alexanderfriman/mars-rover/README.md

# Tellus Stick-To-It-Iveness Rover
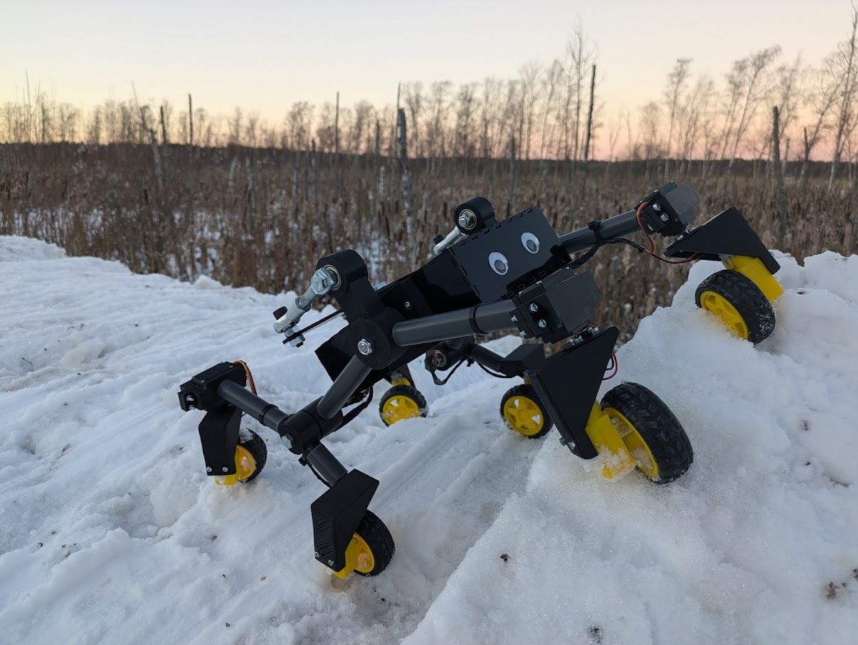
[picture p1: images/tellus_rover.jpg]

Created by: Alexander Friman, Simon Nordgren, Martin Björkell & Jonas Båsk.

## Video
<a href="http://www.youtube.com/watch?feature=player_embedded&v=wtrcZi1KN1w
" target="_blank">IMAGE ALT TEXT HERE</a>

## Introduction
This is a robotics project done at Aalto University for the Sähköpaja course. We built a miniature rover inspired by NASA's mars rover Perseverance. The rover features the rocker-bogie suspensionsystem and Ackermann's steering geometry, but does not include any measuring devices. It is controlled through bluetooth with a PlayStation 4 controller which is connected to an ESP32. 

## Parts
| Amt | Electrical components | 
| --- | --- |
|  1x | ESP32 Wrover E | 
|  2x | TB6612FNG motordriver |
|  6x | DG01D DC-motor |
|  4x | DM996 Servomotors (180 degrees) |
|  2x | 9V powersupply |
|  1x | DC-to-DC step down converter |
|  1x | Breadboard |
|  1x | LD33CV (3.3V) Voltage regulator |
|  1x | Capasitor 100u |
|  1x | PS4 Controller |
| | Wires |

| Amt | Mechanical components |
| --- | --- |
|  2x | Rod-end ball joint (M8) |
|  2x | Eye hinge bolt (M8) |
| 14x | Ball bearings 8x22x7mm |
|  6x | Wheel |
| | PVC pipe 20mm (about 80cm) |
| | Acrylic sheet 3mm |
| | Bolts, nuts, washers, skrews |

## Circuit Diagram
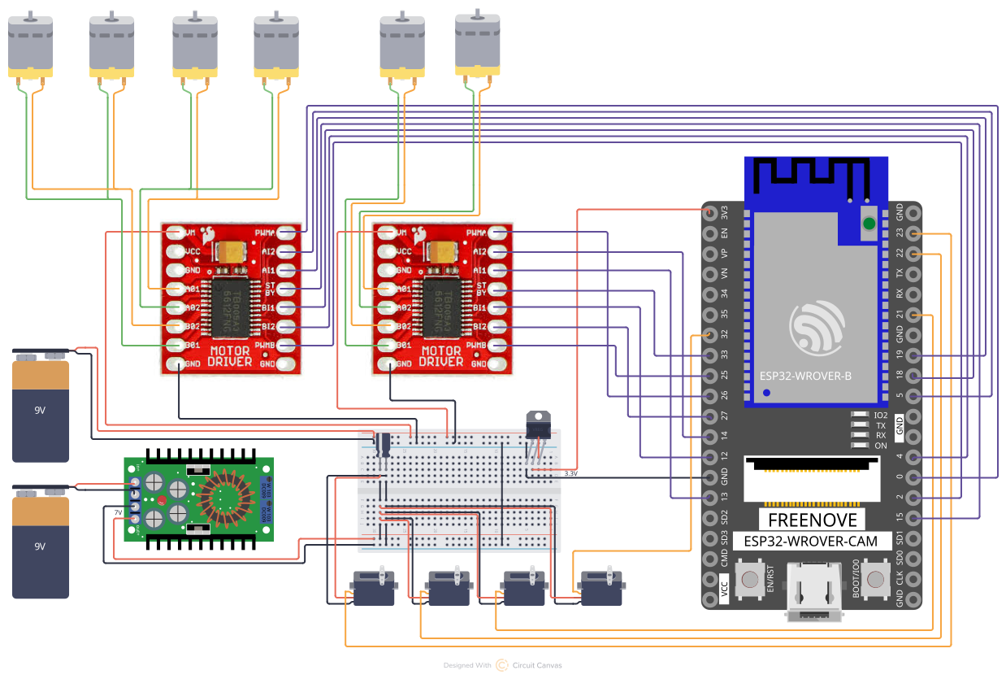
[picture p2: images/Curcuit_Diagram.png]


## 3D-Printed Parts
2x back_servo.stl<br/>
3x box_connector.stl<br/>
2x front_servo.stl<br/>
2x leg_inside.stl<br/>
2x leg_main.stl<br/>
2x leg_outside.stl<br/>
1x middle_wheelpart.stl<br/>
4x outer_wheelpart.stl<br/>
4x servo_backside.stl<br/>

## Acrylic parts
[Acrylic Parts](https://github.com/alexanderfriman/mars-rover/blob/main/Mars_Rover_Box.svg)

## Ackermann steering geometry
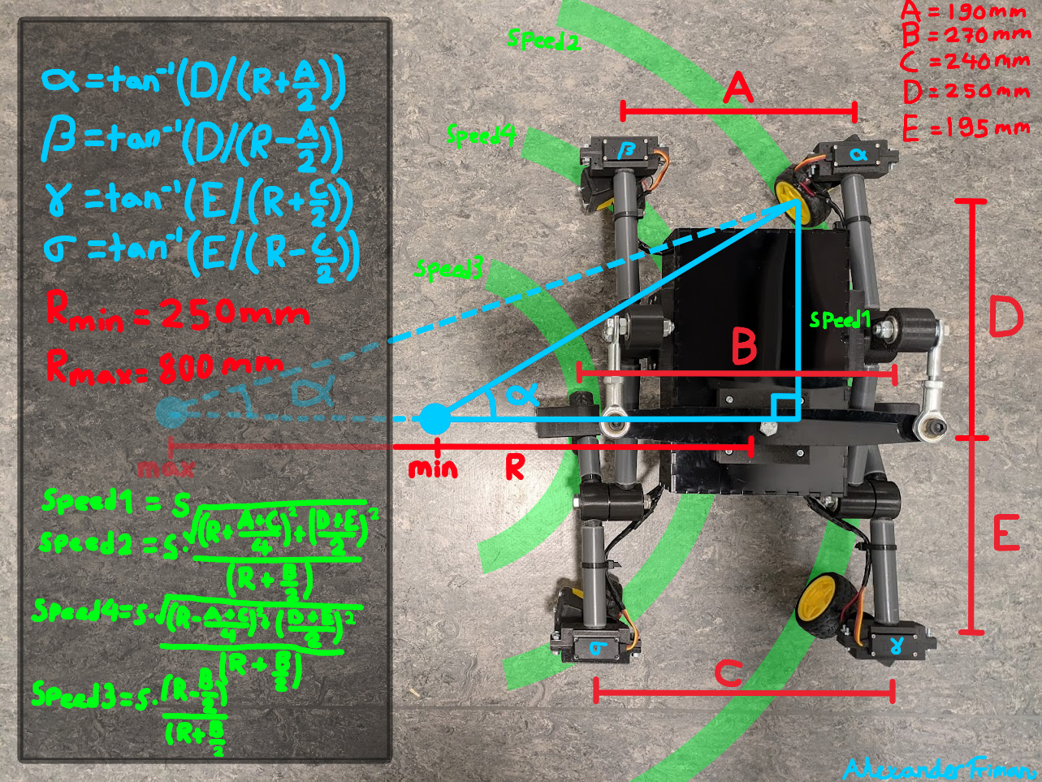
[picture p3: images/Ackermann_steering.png]
