alexanderfriman/mars-rover/3D-parts/leg_main.stl

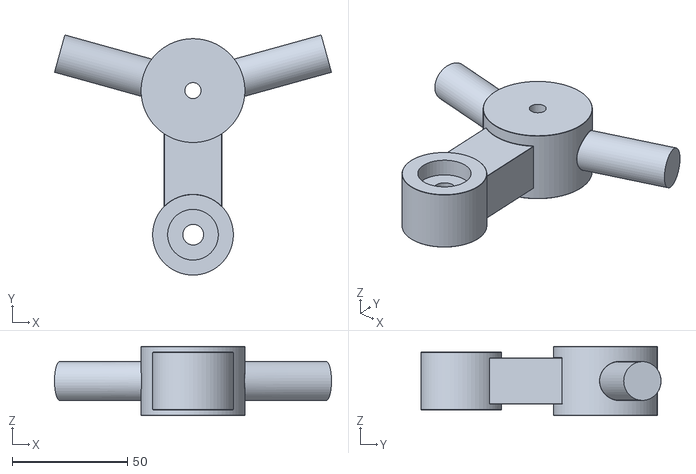
[picture p4: CAD file, 2025-02-15]
3D-parts/leg_main.stl
120.1 x 104.1 x 30.0
