alexanderfriman/mars-rover/3D-parts/servo_backside.stl

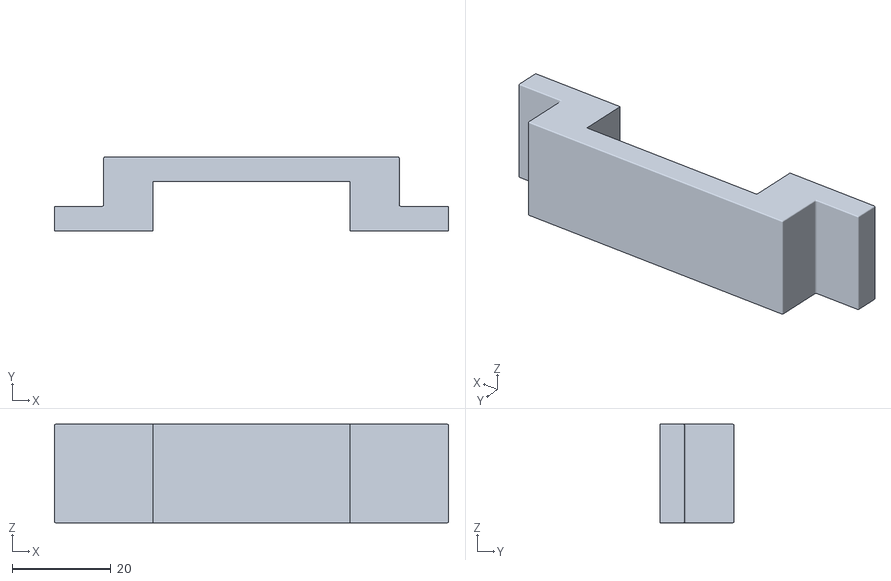
[picture p5: CAD file, 2025-02-15]
3D-parts/servo_backside.stl
80.0 x 15.0 x 20.0
