alexanderfriman/mars-rover/3D-parts/back_servo.stl

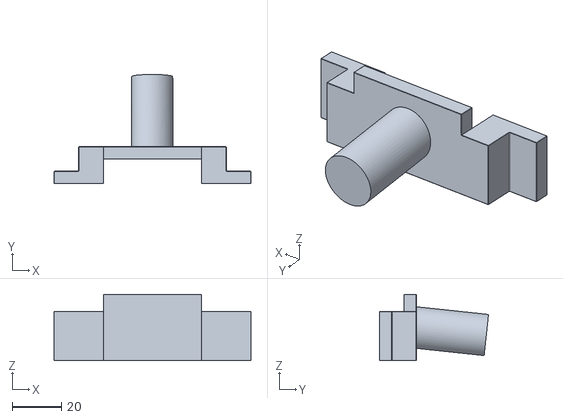
[picture p6: CAD file, 2025-02-15]
3D-parts/back_servo.stl
80.0 x 44.3 x 27.0
