alexanderfriman/mars-rover/3D-parts/outer_wheelpart.stl

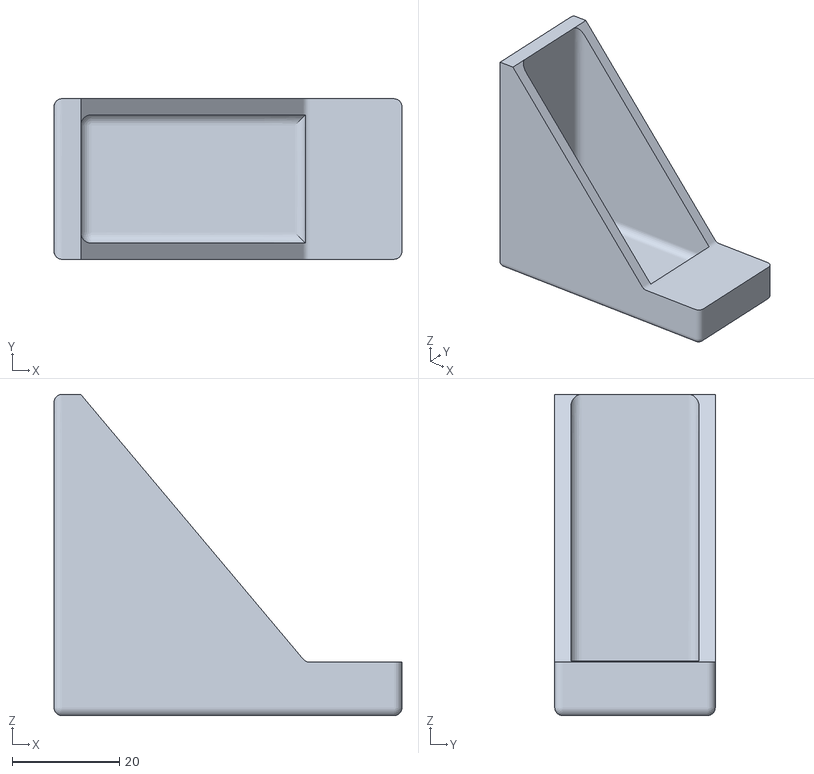
[picture p7: CAD file, 2025-02-15]
3D-parts/outer_wheelpart.stl
65.0 x 30.0 x 60.0
