alexanderfriman/mars-rover/3D-parts/front_servo.stl

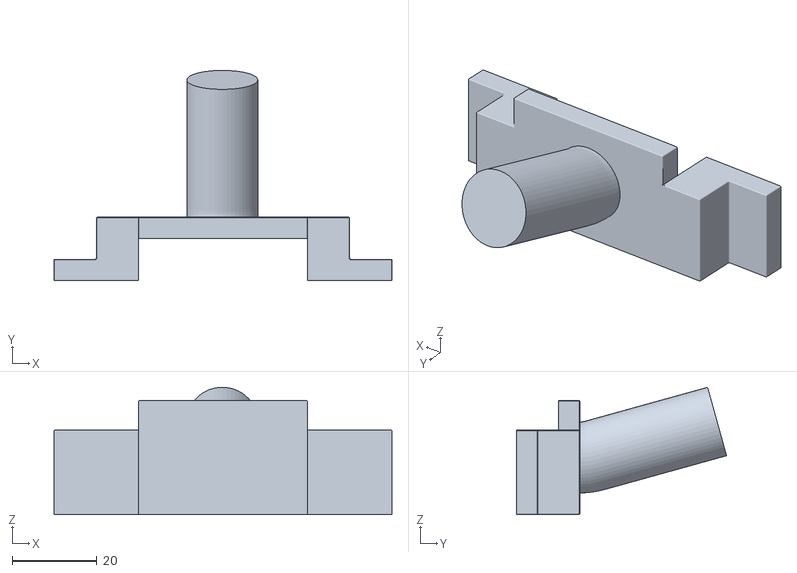
[picture p8: CAD file, 2025-02-15]
3D-parts/front_servo.stl
80.0 x 49.7 x 30.2
