alexanderfriman/mars-rover/3D-parts/leg_inside.stl

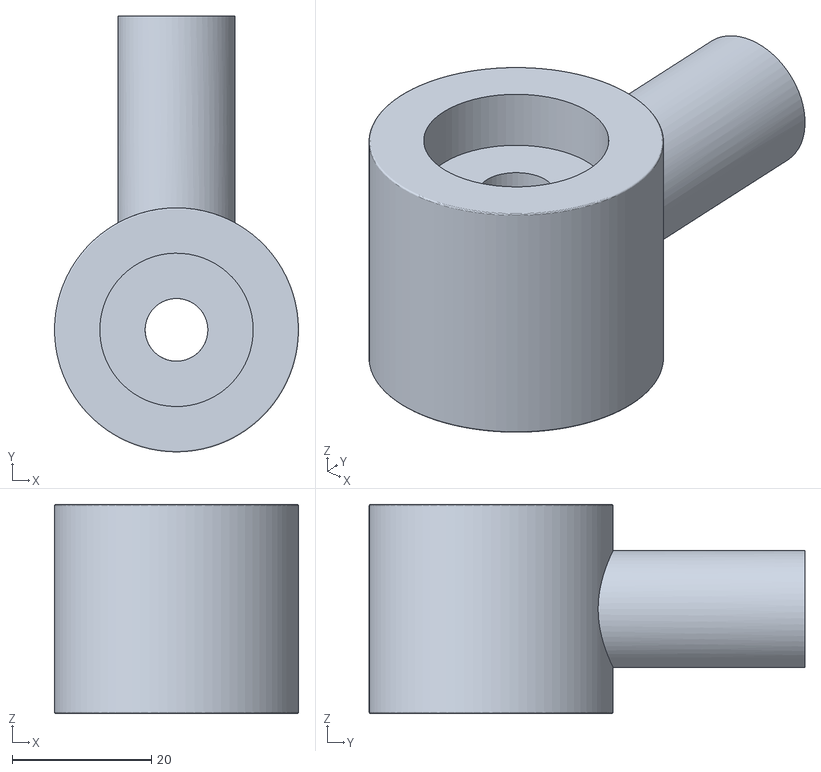
[picture p9: CAD file, 2025-02-15]
3D-parts/leg_inside.stl
35.0 x 62.5 x 30.0
