alexanderfriman/mars-rover/3D-parts/box_connector.stl

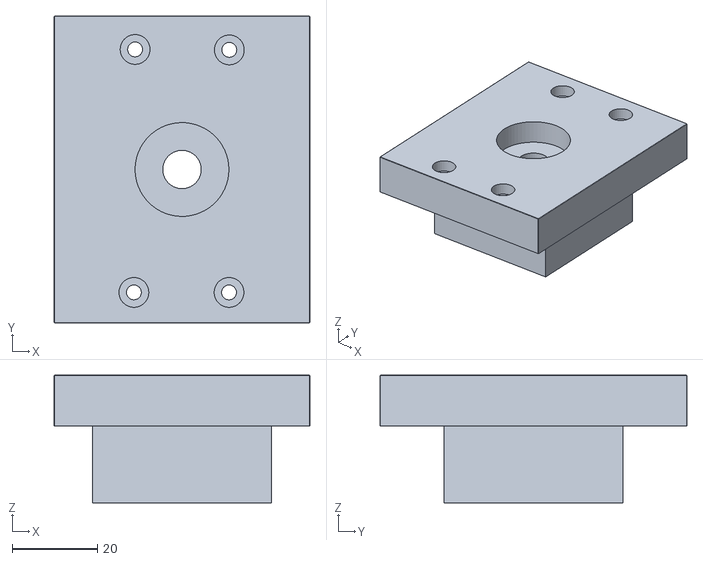
[picture p10: CAD file, 2025-02-15]
3D-parts/box_connector.stl
60.0 x 72.0 x 30.0
