alexanderfriman/mars-rover/3D-parts/leg_outside.stl

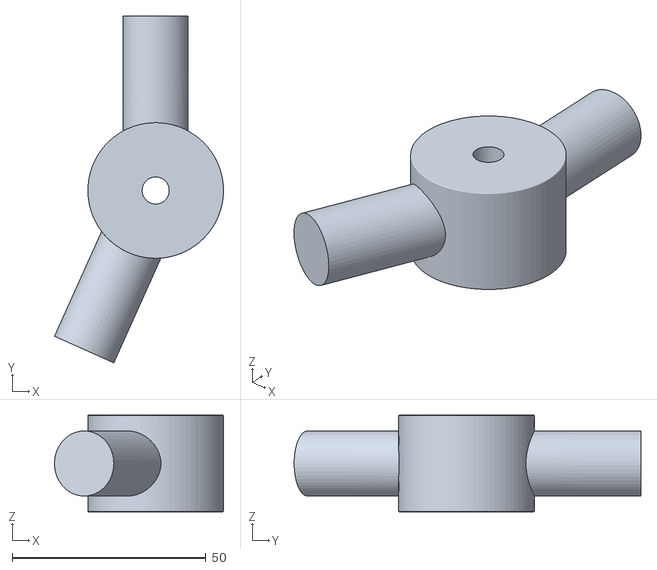
[picture p11: CAD file, 2025-02-15]
3D-parts/leg_outside.stl
43.6 x 89.5 x 25.0
