alexanderfriman/mars-rover/3D-parts/middle_wheelpart.stl

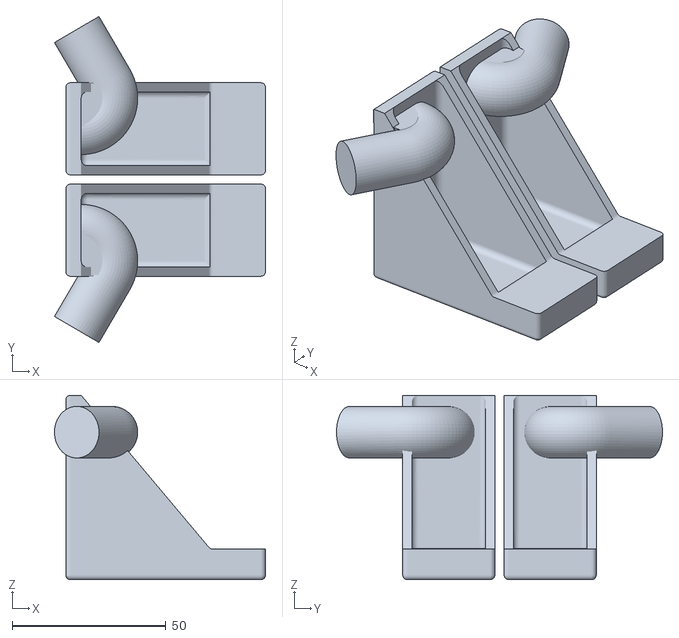
[picture p12: CAD file, 2025-02-15]
3D-parts/middle_wheelpart.stl
68.7 x 106.1 x 60.0
