alexanderfriman/mars-rover/(commit log)

2025-02-15 Added the ESP32 code for the rover.
2025-02-15 Rename Ackermann steering geometry (1).png to Ackermann_steering.png
